tatzelbrumm/gf180_cm_ip__single2diff2single/README.md

# Single-ended / Differential / Single-ended Analog Pad Converter (GF180MCU)

> [!NOTE]
> **Status (2026-10-06):** skeleton. This repository is the GF180MCU (`gf180mcuD`, Chipalooza #3) port of the IHP sg13cmos5l design `sg13cmos5l_cm_ip__single2diff2single`. The build files (`Makefile`, the `xschemrc` files, `submission.yaml`, `.gitignore`, `scripts/`) now target GF180MCU, and every IHP design file has been removed. **No layout, schematic, testbench or netlist exists yet and no Makefile target has been run.** The GF180 harness is unpublished, so slot size, pin interface and precheck rules are assumptions carried over from the IHP version; anything marked *unverified* below is such an assumption. See [`CLAUDE.md`](CLAUDE.md), [`docs/IHP_TO_GF180_PORT_MAP.md`](docs/IHP_TO_GF180_PORT_MAP.md) and [`harness_stub/README.md`](harness_stub/README.md).

(c) 2026 Tim Edwards and Simon Dorrer (the build flow derives from their Chipalooza analog project template)

> [!IMPORTANT]
> This repository requires the [IIC-OSIC-TOOLS](https://github.com/iic-jku/IIC-OSIC-TOOLS) container with tag `2026.08` or later, and a tag that ships the `gf180mcuD` PDK (install it with Ciel otherwise). Not yet checked for the tag you use.

> [!TIP]
> If you want to use `nix-shell` instead of the container, have a look here: [heichips26-template](https://github.com/HeiChips/heichips26-template).

Single-ended analog pads are all a shared-die platform hands to each participant, while on-chip analog blocks should be fully differential for signal range and supply rejection. This design bridges the two: a single-ended analog **input pad** is buffered into a fully differential on-chip signal, and a differential-in **output driver** buffers it back out to a single-ended analog **output pad**.

The top level `gf180_cm_ip__single2diff2single` is drawn **by hand** (analog on top) and uses a **recursive macro structure**: it embeds the two sub-macros [`gf180mcu_IOPadSingle2Diff`](macros/gf180mcu_IOPadSingle2Diff/README.md) (input pad, CDM protection, single-ended-to-differential buffer) and [`gf180mcu_IOPadDiff2Single`](macros/gf180mcu_IOPadDiff2Single/README.md) (class-AB differential-to-single-ended driver, output pad). The pads come from Tim Edwards' `gf180mcu_ocd_io__asig_5p0`, which has HBM diodes only; the CDM protection next to the gates is part of this design.

The whole flow runs inside the [IIC-OSIC-TOOLS](https://github.com/iic-jku/IIC-OSIC-TOOLS) container: Xschem, ngspice, Magic, Netgen, KLayout and the `sak-*` helper scripts.

> [!IMPORTANT]
> `top-cell` in [`submission.yaml`](submission.yaml) has to match `TOP` in the [`Makefile`](Makefile), the file names below and the top cell inside the GDS. The intended name is `gf180_cm_ip__single2diff2single` (not final until confirmed, see `CLAUDE.md` section 1).

[`submission.yaml`](submission.yaml) describes the submission and is what the precheck reads. It carries these fields:

| Field | Meaning |
| --- | --- |
| `project-name` | free-text name of the project |
| `top-cell` | the macro's cell name, unique across all submissions |
| `team-members` | one list entry per person |
| `slot-size` | `tiny`, `small` or `large` (IHP sizes 200 x 200, 500 x 200 and 500 x 415 µm). *Unverified for GF180.* |
| `analog-pins` | how many analog pins the macro uses, `0`-`3`. *Unverified for GF180* (the IHP design used three: vin, vout, vcm). |
| `short-description` | one line |
| `long-description` | the project documentation, Markdown in a YAML block scalar |
| `gds-path`, `lef-path`, `header-path` | globs for the three deliverables, each must match **exactly one** file |

Because the submission macro is the **top level** of this repository rather than a folder under `macros/`, the three paths are relative to the repository root:

```yaml
gds-path: final/gds/*.gds
lef-path: final/lef/*.lef
header-path: final/vh/*.vh
```

They are produced by `make build-top`, so run it once before submitting.

To rename the project, change `TOP` in the [`Makefile`](Makefile) (every target derives its file names from it) and in the two macro Makefiles if a macro is renamed, and rename the files that carry the name:

- `layout/klayout/<TOP>.klay.gds` and `.klay.klib`, `layout/gds/<TOP>.gds`, **and the top cell inside the GDS files** (open in KLayout, rename the cell, save). The DRC, LVS and PEX targets pass the file name as the cell name, so the two must match.
- `schematic/xschem/<TOP>.sch` and `.sym` (`_pex.sym` is regenerated by `symbol-pex`)
- `testbenches/xschem/<TOP>_tb_tran.sch`
- `testbenches/xschem/plot_simulations/plot_<TOP>.py`

Then search and replace the remaining occurrences inside those files (Xschem schematics and the plot script are plain text): the DUT symbol instances, the `.include` of the PEX netlist in the testbench, and the raw file names in the plot script. Finally set `top-cell` in [`submission.yaml`](submission.yaml) to the same name.

## Directory Structure

<details>
<summary>Show Directory Structure</summary>

```text
📁 gf180_cm_ip__single2diff2single/            # <TOP> = the top-cell name, see CLAUDE.md §1
├─ .designinit  .gitignore  .gitattributes  LICENSE
├─ CLAUDE.md  README.md  Makefile  submission.yaml
├─ 📁 docs/                          # GF180_PROCESS_OPTIONS, OPERATING_LIMITS, IHP_TO_GF180_PORT_MAP
├─ 📁 dependencies/                  # links to gf180mcu_ocd_io etc.; nothing vendored yet
├─ 📁 harness_stub/                  # assumed slot interface until the GF180 harness is published
├─ 📁 floorplan/                     # GF180 slot templates: none exist yet (README only)
├─ 📁 final/                         # generated by `make build-top`, absent until the first run
│  ├─ 📁 gds/  📁 lef/  📁 lib/  📁 vh/       # <TOP>.gds, .lef, .lib, .vh
├─ 📁 layout/
│  ├─ 📁 klayout/                    # KLayout editing source: <TOP>.klay.gds + <TOP>.klay.klib
│  ├─ 📁 magic/                      # Magic editing source (*.mag), only for a cell authored in Magic
│  └─ 📁 gds/                        # exported static <TOP>.gds, what every build and sign-off target reads
├─ 📁 macros/
│  ├─ 📁 gf180mcu_IOPadSingle2Diff/  # analog input pad + CDM protection + S2D buffer
│  │  ├─ Makefile  README.md
│  │  ├─ 📁 layout/{klayout,magic,gds}/   # same three roles as at the top level
│  │  └─ 📁 schematic/xschem/  📁 testbenches/xschem/  📁 scripts/   # xschemrc files, check_pex_ports.py
│  ├─ 📁 gf180mcu_IOPadDiff2Single/  # D2S class-AB driver + analog output pad, same structure
│  ├─ 📁 ClassABDriver/  📁 ClassABBias/  📁 PadEnable/   # building blocks of the pads (2026-10-08)
│  └─ 📁 OgueyAebischerBias/         # resistor-free bias reference
├─ 📁 netlist/                       # generated, absent until the first run
│  ├─ 📁 layout/                     # *_klayout.cir (KLayout LVS), *_magic.ext.spc (Magic LVS)
│  ├─ 📁 pex/                        # *_magic_pex_*.spice
│  └─ 📁 schematic/                  # *_klayout.cdl, *_magic.spice
├─ 📁 render/img/                    # generated
├─ 📁 schematic/xschem/              # <TOP>.sch, .sym, _pex.sym, xschemrc
├─ 📁 scripts/                       # check_boundary.py, check_pex_ports.py, extract_pad.py, pcells/
├─ 📁 testbenches/xschem/            # <TOP>_tb_tran.sch, plot_simulations/, xschemrc
└─ 📁 verification/                  # generated
   ├─ 📁 drc/  <cell>.klayout.drc/  <cell>.magic.drc/
   └─ 📁 lvs/  <cell>.klayout.lvs/  <cell>.magic.lvs/
```

</details>

## Recursive Macro Structure

This project embeds two sub-macros in `macros/`, and each level has its own Makefile with the same targets:

- **Top level (`gf180_cm_ip__single2diff2single`)**: the hand-drawn submission macro. Its layout instantiates the two macros below. Its Makefile verifies and builds the **top cell only** (`CELL` defaults to `gf180_cm_ip__single2diff2single`).
- **[`macros/gf180mcu_IOPadSingle2Diff/`](macros/gf180mcu_IOPadSingle2Diff/README.md)** (`TOP = gf180mcu_IOPadSingle2Diff`): analog input pad, CDM protection, single-ended-to-differential buffer.
- **[`macros/gf180mcu_IOPadDiff2Single/`](macros/gf180mcu_IOPadDiff2Single/README.md)** (`TOP = gf180mcu_IOPadDiff2Single`): class-AB differential-to-single-ended driver and analog output pad.
- **[`macros/OgueyAebischerBias/`](macros/OgueyAebischerBias/README.md)** (`TOP = OgueyAebischerRef_<VARIANT>`, `VARIANT` = `03v3` or `06v0`): resistor-free bias current reference with start-up, ported from IHP in two device-family variants. Has `sim-cace` / `sim-cace-all` targets. Not yet part of `build-macros`.
- **[`macros/ClassABDriver/`](macros/ClassABDriver/README.md)**: the class-AB driver core (matched-pair DDA, folded cascode, class-AB output, Miller compensation) and its CACE fixture `ClassABDriverBiased`; ported from the IHP design notes, re-sized for GF180 (2026-10-08).
- **[`macros/ClassABBias/`](macros/ClassABBias/README.md)**: the driver's bias trees `ClassABBiasIn` / `ClassABBiasOut` (reference current into / out of `iref`) and the ideal fixture `ClassABBiasIdeal`, each with its own CACE suite.
- **[`macros/PadEnable/`](macros/PadEnable/README.md)**: enable cells of the analog pads (`EnableInv`, `DriverEnable`, `BiasRefEnable`, `InputEnable`).
  Their Makefiles (and the changes to the existing ones: `sim-cace`, `sim-cace-all`, `make sim-cace-macros` at the top) come as a package, because the bridge cannot write Makefiles: `_sudelbuecher/sudelbuecher/deliveries/2026-10-08_opus_makefiles.zip`, installed with its `install.sh`.

The macro Makefiles were derived from the template's analog sub-macro Makefile; its CACE characterization targets were dropped, and the PDK, layout and name strings were retargeted. They have not been run for GF180. Every level follows the same principle, and the simulations always run last, so they use the artifacts the same invocation has just produced:

| Makefile | `all` flow |
| --- | --- |
| each macro | verify (DRC, LVS, PEX) → build (LEF, LIB, Verilog stub, GDS, render) → simulate |
| top level | build macros → verify (DRC, LVS, PEX) → build (boundary check, LEF, LIB, Verilog stub, GDS, render) → simulate |

**Build order matters**: if you modify a sub-macro, run its own flow first (`make -C macros/gf180mcu_IOPadSingle2Diff all`, or equivalently `make build-single2diff` / `make build-diff2single` from here), then rebuild the top level. The top-level `make all` does this automatically by running `build-macros` before verifying and building the top cell. A macro's exported GDS `layout/gds/<macro>.gds` is what the top-level `.klib` binds to, see the next sections.

## Floorplan Templates

None for GF180 yet. The IHP slot templates were removed because their geometry, pin positions and layers do not apply. Slot geometry, wrapper interface and precheck rules arrive with `gf180mcu_ocd_chipalooza`, which is still empty; until then [`harness_stub/README.md`](harness_stub/README.md) holds the assumed interface and [`floorplan/README.md`](floorplan/README.md) the status.

## Layout Sources and the Exported Tapeout GDS

`layout/` is split by role, the same "source vs. derived artifact" idiom as `netlist/{schematic,layout,pex}` and `verification/{drc,lvs}`. The file's location tells you whether it is safe to edit or gets overwritten by a re-export. Every macro under `macros/` uses the same three subdirectories.

| Directory | Holds | Edited by hand? |
| --- | --- | --- |
| `layout/klayout/` | KLayout editing source `<TOP>.klay.gds` + `<TOP>.klay.klib` (live PCells, library references), plus KLayout's own generated folders (`backups/`, `drc_run_*`, `lvs_run_*`) | yes |
| `layout/magic/` | Magic editing source `*.mag`, only for a cell that is authored in Magic | yes, if used |
| `layout/gds/` | exported static `<TOP>.gds`: no PCells, no library indirection | never, regenerate |

Rules:

1. **One authoring tool per cell.** Two hand-edited sources of the same cell have no merge story: edit one and the other silently goes stale, and only a DRC/LVS mismatch reveals it. The directory of the tool that is not used stays empty (`.gitkeep`) or carries a short `NOTE.md` saying so, for example "this cell is authored in KLayout, see `layout/klayout/`".
2. **The export always goes to `layout/gds/<cell>.gds`**, whichever tool authored the cell. `gds` is the tool-agnostic exported view, the counterpart of `final/gds/` one level up; it is not "KLayout's output folder", which is why it is not the partner of `magic`. Every DRC, LVS, PEX and build target reads this file. If both tools ever produce a GDS of the same cell, they get tool suffixes, `<cell>_klayout.gds` and `<cell>_magic.gds`, exactly like `netlist/layout/*_klayout.cir` next to `*_magic.ext.spc`, and never overwrite each other.
3. **A parent binds a child macro to the child's exported GDS, never to its editing source.** In `layout/klayout/<TOP>.klay.klib` the `lib_path` of a macro is `../../macros/<macro>/layout/gds/<macro>.gds` (relative to the `.klib`). The hierarchy therefore only consumes a finished snapshot of the level below and never reaches into its live editing state. Rename a macro and `lib_name` and `lib_path` must follow.
4. **Launch KLayout from the file's own directory**, `cd layout/klayout && klayout -e <TOP>.klay.gds`, because the relative `lib_path` depends on it. `make open` does this.

> [!IMPORTANT]
> Re-export to `layout/gds/<TOP>.gds` with `File > Export Layout For Tapeout` after every layout change and never hand-edit the exported file. Keeping the two in step by editing both is how they drift apart, and the drift is invisible because the sign-off targets only look at the exported file.

The export re-evaluates the PCells against the **installed** PDK, so device geometry can change even though nobody touched the editing source. A layout carried over from another PDK, another PDK revision or a different template therefore has to be re-exported under the target PDK and re-checked, not copied. This applies to everything inherited from the IHP version of this design. Re-run DRC, LVS and PEX after every export.

The Makefiles follow this convention strictly: every DRC, LVS, PEX and build target reads `layout/gds/<cell>.gds` and nothing else (`LAY_GDS_DIR` in the Makefile). The IHP sibling project's Makefile falls back to `layout/klayout/<cell>.klay.gds` when no exported GDS exists; this project deliberately does not, so a forgotten export fails loudly instead of checking a stale or unresolved source. The three-directory convention and its history are discussed in the IHP sibling project's notes: [`2026-09-27_sonnet_single2diff2single_toplevel_structure_and_chipalooza_magic_authoring.md`](../sg13cmos5l_cm_ip__single2diff2single_sudelbuecher/sudelbuecher/chatlog/2026-09-27_sonnet_single2diff2single_toplevel_structure_and_chipalooza_magic_authoring.md), Turns 14, 19 and 21 to 23.

## Xschem Configuration

Xschem reads exactly one `xschemrc` at start-up, and that file decides which symbol libraries are visible and where netlists and simulation output are written. This project ships one per folder that holds schematics:

| `xschemrc` | Belongs to |
| --- | --- |
| [`schematic/xschem/xschemrc`](schematic/xschem/xschemrc) | top-level schematics |
| [`testbenches/xschem/xschemrc`](testbenches/xschem/xschemrc) | top-level testbenches |
| [`macros/gf180mcu_IOPadSingle2Diff/schematic/xschem/xschemrc`](macros/gf180mcu_IOPadSingle2Diff/schematic/xschem/xschemrc) | input pad macro schematics |
| [`macros/gf180mcu_IOPadSingle2Diff/testbenches/xschem/xschemrc`](macros/gf180mcu_IOPadSingle2Diff/testbenches/xschem/xschemrc) | input pad macro testbenches |
| [`macros/gf180mcu_IOPadDiff2Single/schematic/xschem/xschemrc`](macros/gf180mcu_IOPadDiff2Single/schematic/xschem/xschemrc) | output driver macro schematics |
| [`macros/gf180mcu_IOPadDiff2Single/testbenches/xschem/xschemrc`](macros/gf180mcu_IOPadDiff2Single/testbenches/xschem/xschemrc) | output driver macro testbenches |
| [`macros/OgueyAebischerBias/schematic/xschem/xschemrc`](macros/OgueyAebischerBias/schematic/xschem/xschemrc) | bias macro schematics |
| [`macros/OgueyAebischerBias/testbenches/xschem/xschemrc`](macros/OgueyAebischerBias/testbenches/xschem/xschemrc) | bias macro testbenches |
| `macros/{ClassABDriver,ClassABBias,PadEnable}/{schematic,testbenches}/xschem/xschemrc` | building blocks of the pads; each also appends the sibling macros it instantiates |

### What Every File Does

All of them run the same four steps, in this order:

1. **Pick the PDK.** `PDK_ROOT` is probed in the usual install locations if the environment does not set it, and `PDK` falls back to `gf180mcuD`. The container already exports `PDK_ROOT`, and [`.designinit`](.designinit) exports `PDK`, so this step is only a safety net for an Xschem started outside that environment.
2. **Source the PDK `xschemrc`.** `$PDK_ROOT/$PDK/libs.tech/xschem/xschemrc` brings in the GF180 device symbols, the ngspice model paths and the PDK menu. It is guarded by `[info exists PDK]` so it is read once even when several project files are chained.
3. **Add the project library paths.** `append_xschem_library_path_unique` appends a folder to `XSCHEM_LIBRARY_PATH` only if it is not already there, so the same folder never appears twice no matter how the files are chained.
4. **Pin the netlist directory.** `pin_netlist_dir` decides where `xschem netlist` and the simulators write.

Both helper procedures are defined behind an `[info commands ...]` guard, so sourcing one file from another is harmless and the order does not matter.

### How the Files Are Chained

The top level pulls in everything below it:

```text
testbenches/xschem/xschemrc
└─ source schematic/xschem/xschemrc
   ├─ source macros/gf180mcu_IOPadSingle2Diff/schematic/xschem/xschemrc
   ├─ source macros/gf180mcu_IOPadDiff2Single/schematic/xschem/xschemrc
   ├─ source macros/OgueyAebischerBias/schematic/xschem/xschemrc
   ├─ source macros/ClassABBias/schematic/xschem/xschemrc
   ├─ source macros/ClassABDriver/schematic/xschem/xschemrc
   └─ source macros/PadEnable/schematic/xschem/xschemrc
```

Each schematic folder puts itself and its sibling testbenches folder on the library path, and each testbenches folder does the reverse. The top level therefore sees all the schematic and testbench folders, which is what lets the top-level schematic instantiate the macro symbols, and what lets you open a macro testbench from a top-level session. The macro files do not source each other or the top level, so a macro can be opened and simulated on its own. A macro that instantiates cells of another macro (the pads, `ClassABDriver`) appends that macro's `schematic/xschem` folder with a relative path instead (`../../../<Macro>/schematic/xschem`).

Add a further sub-macro to the top level by sourcing its `schematic/xschem/xschemrc` from [`schematic/xschem/xschemrc`](schematic/xschem/xschemrc), next to the existing `source` lines.

### Where Netlists and Simulation Output Go

`pin_netlist_dir` maps the folder of the schematic being netlisted to a `simulations/` folder:

| Schematic lives in | `netlist_dir` |
| --- | --- |
| `<x>/testbenches/xschem` | `<x>/testbenches/xschem/simulations` |
| `<x>/schematic/xschem` | `<x>/testbenches/xschem/simulations` |
| `.../cace/templates` | `.../cace/templates/simulations` (kept from the template, no CACE folder exists here) |
| anywhere else (a PDK example) | left at the value the `xschemrc` pinned |

It runs twice: once while the `xschemrc` is read, using that file's own folder, and again through Xschem's `load_file_postprocess` hook for every schematic that is opened afterwards. The second call is the important one. Because the top level puts the macro folders on the library path, a macro testbench can be opened from a top-level session, and without the hook its netlist would land in `testbenches/xschem/simulations/`. Its relative includes such as `.include ../../../netlist/pex/gf180mcu_IOPadSingle2Diff_magic_pex_3.spice` are resolved by ngspice relative to the netlist file, so they would then point at the wrong tree and the simulation would abort. With the hook, the netlist always lands next to its own schematic and the includes resolve.

A `set netlist_dir` passed on the Xschem command line still wins, because `--command` runs after the file is loaded. The LVS netlist targets rely on this to write into `netlist/schematic/` instead.

All `simulations/` folders are generated and git-ignored.

### Which File Is Used

- The Makefile targets always name one explicitly with `--rcfile`, so a target behaves the same from any working directory.
- Starting Xschem from within one of the folders above picks up that folder's file, which is the normal interactive case. `make open` does the same, because it starts Xschem in the file's own directory.
- Started from anywhere else, Xschem falls back to `~/.xschem/xschemrc` and sees neither the project symbols nor the pinned `netlist_dir`. Pass the file explicitly then, for example `xschem --rcfile schematic/xschem/xschemrc <file>`.

## Verification Scripts (`sak-*`)

The DRC, LVS, PEX, render and file-browser targets call the `sak-*` Swiss-Army-Knife scripts of the [IIC-OSIC-TOOLS](https://github.com/iic-jku/IIC-OSIC-TOOLS). They are pre-installed in the container and are on `PATH`, so the Makefiles call them by name and no copy is kept in this repository:

- `sak-drc.sh` — DRC with Magic or KLayout
- `sak-lvs.sh` — LVS with Magic + Netgen or KLayout
- `sak-pex.sh` — parasitic extraction with Magic
- `sak-pin-reorder.py` — reorders extracted `.subckt` pins to match an Xschem symbol
- `sak-render.py` — renders a layout GDS to PNG
- `sak-open.py` — the file browser behind `make open`

They read `PDK_ROOT`, `PDK`, `PDKPATH` and `STD_CELL_LIBRARY` from the environment. The container exports `PDK_ROOT`, and [`.designinit`](.designinit) exports the other three. IIC-OSIC-TOOLS sources `$DESIGNS/.designinit` at start-up, so the file is picked up automatically when this repository is the mounted design directory. If the repository sits in a subfolder of `$DESIGNS`, or you are in a shell that was not started that way, source it by hand before running any target:

```sh
source .designinit
```

Only two Python helpers are kept in [`scripts/`](scripts/) (each macro carries its own copy of `check_pex_ports.py`), because they are specific to this project:

- [`scripts/check_boundary.py`](scripts/check_boundary.py) — the PR boundary check, see below
- [`scripts/check_pex_ports.py`](scripts/check_pex_ports.py) — checks that every port of a PEX netlist is really connected

The `sak-render.py -t` tech name is a Makefile variable, `RENDER_TECH` (default `gf180mcuD`), and `gf180mcuD` is a PDK name that `sak-pdk` lists in the container, the same kind of name the IHP version passed. It has not yet been run through `sak-render.py` itself. KPEX has no verified GF180 support, so use the Magic PEX targets.

## Makefile Targets

The top-level Makefile has the same structure as each macro's (same variables, same targets) with `TOP = gf180_cm_ip__single2diff2single`; the macro Makefiles use their own macro name as `TOP`. The parameters are `CELL`, `EXT_MODE`, `THRESHOLD`, `MINRES`, `MINDELAY`, `DRC_LEVEL`, `EV_PRECISION`, `TB`, `SCRIPT`, `OPEN_ARGS` and `RENDER_TECH`, documented in the Makefile header and by `make help`. In short:

```sh
make                                     # help: all targets and variables
make open                                # file browser for this folder (needs the VNC/X11 desktop)
make klayout-verify-all                  # KLayout DRC + LVS of the top cell
make magic-verify-all                    # Magic DRC + LVS + PEX of the top cell
make check-boundary                      # PR boundary box check of the top cell layout
make build-top                           # boundary check, LEF, LIB, Verilog stub, final GDS, render
make build-single2diff                   # full flow of the gf180mcu_IOPadSingle2Diff macro (make -C macros/... all)
make build-diff2single                   # full flow of the gf180mcu_IOPadDiff2Single macro
make build-macros                        # verify, build and simulate both macros
make sim-all                             # run all top-level testbenches
make sim-xschem                          # top-level transient (default: <CELL>_tb_tran, needs magic-pex first)
make sim-xschem TB=<testbenchname>       # run another testbench
make sim-view-xschem                     # plot the results (default: plot_<CELL>)
make sim-view-xschem SCRIPT=<scriptname> # run another plotting script
make all                                 # build-macros + verify + build + simulate
make clean                               # delete the top level's generated files (final, netlist, render, reports, simulations)
make clean-single2diff                   # run make clean in the gf180mcu_IOPadSingle2Diff macro
make clean-diff2single                   # run make clean in the gf180mcu_IOPadDiff2Single macro
make clean-macros                        # run make clean in both macros
make clean-all                           # clean-macros + clean
```

The per-step targets behind these all take `CELL=<cellname>`: `klayout-drc`, `klayout-lvs-netlist`, `klayout-lvs`, `klayout-pex`, `klayout-verify`, `magic-drc`, `magic-lvs-netlist`, `magic-lvs`, `magic-pex`, `magic-verify`, `symbol-pex`, and the build steps `lef`, `lib`, `verilog`, `copy-gds`, `render-gds`. The `verilog` target recognizes the supply pins `VDD`, `VSS`, `VPWR`, `VDPWR`, `VAPWR`, `VGND`, `VNB`, `VPB` and the direction prefixes `di_`/`do_`; adjust both once the harness's supply and pin naming is known.

### Open the Design Files

Opens a file browser for this folder with `sak-open.py`, one button per design file, grouped by directory. Clicking a button launches the matching tool (Xschem, KLayout in edit mode, Magic, GTKWave, gaw, gvim) in the file's own directory:

```sh
make open
make open OPEN_ARGS=--all              # include the build outputs
make open OPEN_ARGS="--prune backups"  # skip one more directory name
```

> [!NOTE]
> This target needs a display. Run it inside the container's VNC/noVNC desktop or over X11 forwarding. In a shell-only container it stops with `cannot open a window`.

### PR Boundary Check

Checks that the top cell of `layout/gds/<TOP>.gds` draws the PR boundary box on layer 0 (`PR_bndry`, 0/0). `build-top` runs it first:

```sh
make check-boundary
```

The layer number is *unverified* against the harness: it is read from the PDK sources (`PR_bndry 0/0` in `gf180mcu.lyp`, `calma BOUND 0 0` in `gf180mcuD.tech`; the IHP value was 189) and has not been checked against a real GF180 GDS or the precheck. Override it with `scripts/check_boundary.py --layer <n>`. The IHP chip flow derived the bounding box of every macro from this layer, and a layout without the box failed the whole chip build with `Failed to extract PR boundary from GDSII view of macro '<TOP>'`; whether the GF180 flow works the same way is not known until the harness is published. The check runs [`scripts/check_boundary.py`](scripts/check_boundary.py), which also warns when the drawn geometry extends beyond the boundary box.

The sub-macros have no such target: the box is only needed by the cell the chip flow places, which is the top level.

### Differences to the Sub-Macros

- `sim-all` runs only the top-level testbenches (`<TOP>_tb_tran`). The testbench simulates the schematic by default and includes the extracted PEX netlist by swapping the DUT to the `_pex` symbol for a post-layout run. That symbol, `schematic/xschem/<CELL>_pex.sym`, is built by the `symbol-pex` target, which `klayout-pex` and `magic-pex` run automatically before every extraction. The macros' own testbenches live in `macros/<macro>/testbenches/xschem/`.
- `klayout-verify-all`/`magic-verify-all` verify the top cell only; the macros are covered by `build-macros` (or run the macro's own `make`).
- `build-top` additionally runs `check-boundary` first, see above.
- `make all` first runs `build-macros`, so the sub-macros are verified, built and simulated before the top cell.
- `clean` deletes only the top level's generated files (`final/`, `netlist/`, `render/img/`, the DRC/LVS reports, and the simulation outputs). `clean-macros` runs `make clean` in every sub-macro, and `clean-all` combines both, mirroring `build-macros`/`all`.

> [!NOTE]
> The top-level testbench is expected to `.include` the extracted PEX netlist `netlist/pex/<TOP>_magic_pex_3.spice`, and `make verilog` reads its pin list from a PEX netlist as well. Directly after `make clean`, run `make magic-pex` (or the full `make all`) once before `make sim-xschem`, `make sim-all` or `make build-top`, otherwise the include fails.

> [!WARNING]
> If you commit the generated outputs, `make clean` leaves a large deletion set in `git status`. Run `git restore .` to get them back if you did not mean to remove them.

## License

Copyright 2026 Tim Edwards and Simon Dorrer.

Licensed under the **Solderpad Hardware License v2.1** (`Apache-2.0 WITH SHL-2.1`), see [`LICENSE`](LICENSE). Source files carry an `SPDX-FileCopyrightText` header; layout data, netlists, renders and generated reports cannot carry one and are covered by this notice.
