tatzelbrumm/gf180_cm_ip__single2diff2single/dependencies/README.md

# dependencies

Nothing is vendored yet. Links only:

- [gf180mcu_ocd_io](https://github.com/RTimothyEdwards/gf180mcu_ocd_io): analog and digital I/O cells (dual-voltage, 3.3 V core / 5 V pad); analog pad is cell `asig_5p0`
- [gf180mcu_ocd_chipalooza](https://github.com/RTimothyEdwards/gf180mcu_ocd_chipalooza): the harness (empty as of 2026-09-30)
- [gf180mcu_ocd_ip__analog_switches](https://github.com/RTimothyEdwards/gf180mcu_ocd_ip__analog_switches): analog and power switches
- [google/gf180mcu-pdk](https://github.com/google/gf180mcu-pdk): original PDK sources; `gf180mcuD` comes via open_pdks / Ciel
