tatzelbrumm/gf180_cm_ip__single2diff2single/macros/ClassABBias/README.md

<!--
SPDX-FileCopyrightText: 2026 Christoph Maier
SPDX-License-Identifier: Apache-2.0
-->
# ClassABBias (GF180MCU)

Bias of the class-AB pad driver (`../ClassABDriver`): six bias lines, generated by diode-connected devices on the
rail of the devices they bias, so that bias crosses from block to block as currents only.

| line | current | diode | biases (in ClassABDriver) |
|---|---|---|---|
| vbp | 5 µA out of | BP 20u/6u nf=2 | DDA unit tails Ta, Tb |
| vbn | 5 µA into | BN 6u/6u | fold sinks SX, SY |
| vbpc | 2 µA out of | BPC 1u/4u | mirror cascodes PCL, PCR |
| vbnc | 2 µA into | BNC 1u/8u | fold cascodes CX, CY |
| vabp | 5 µA out of | RP2 6.66u/0.6u on RP1 12u/0.6u nf=2 | class-AB control ABP, FPL |
| vabn | 5 µA into | RN2 4.4u/1u on RN1 8u/1u nf=2 | class-AB control ABN, FNL |

RP1 and RN1 are the replicas of the output devices OP and ON and sit on the output-stage rails vddo / vsso, like
OP and ON: any voltage between vdd and vddo adds to the translinear loop and moves the quiescent current. In layout,
RP1's source is taken from OP's source rail and RN1's from ON's (Kelvin). RP2's n-well stays on vdd, like ABP's.

**Status: proof of concept (2026-10-08).** Schematics, symbols and CACE suites; no layout. Port of the IHP
sg13cmos5l design notes (`sg13cmos5l_..._sudelbuecher/sudelbuecher/design_considerations/class_ab_pad_driver/improvements/`:
`bias.md`, `sim/d2s_bias_ref.spice`, `xschem/d2s_bias_*.sch`), 03v3 devices at 3.3 V.

## Cells

| cell | IHP sheet | ports | content |
|---|---|---|---|
| `ClassABBiasIn` | `d2s_bias_in` | vdd vss vddo vsso iref vbp vbn vbpc vbnc vabp vabn | variant 1: 5 µA **into** iref (external PMOS source) → NMOS input diode NI 6u/6u; NI's gate line drives the sinks out of the PMOS diodes, BP's gate line the sources into the NMOS diodes |
| `ClassABBiasOut` | `d2s_bias_out` | same | variant 2: 5 µA **out of** iref (external NMOS sink) → PMOS input diode PI 20u/6u |
| `ClassABBiasIdeal` | `d2s_bias_lp` | vdd vss vddo vsso + six lines | test fixture: ideal currents into the same six diodes (used by `ClassABDriverBiased`) |

| `ClassABBiasBG` | `bg_core` (re-designed) | vdd vss iout en en_b | **self-contained bandgap reference**, 5 µA **out of** iout, for the `ClassABBiasIn` tree's iref; with start-up and the disable switches SPG / SKS inline (2026-10-09, see below) |
| `ClassABBiasBGdn` | same | same | the same core with the NMOS pair NA / NB in isolated p-wells (deep n-well), bulk tied to source |
| `ClassABBiasBGTree`, `…BGdnTree` | — | as `ClassABBiasIn` plus en en_b, without iref | CACE fixtures: reference feeding the tree (iout → iref directly) |

Each tree sheet is flat at transistor level, as on IHP: reference [R], mirror tree and the six diodes [8]. The
Oguey–Aebischer variant (`d2s_bias_oa`) is not ported (deferred 2026-10-08; it needs a GF180 re-design: the IHP MS1
is 0.5/100 µm, the bin ends at L = 50 µm).

The pad (`../gf180mcu_IOPadDiff2Single`) uses `ClassABBiasIn` behind `PadEnable/BiasRefEnable`.

## Sizing (re-derived for GF180, 2026-10-08)

Started from the IHP geometry; changed where GF180 simulation required it (details: notes worktree,
`logs/main/2026-10-08_opus_classab_port_log.md`):

- vbp diode BP and its copies 5u/6u → 20u/6u nf=2, together with the DDA unit tails: at ss/3.0 V/−40 °C the
  5u/6u tails had V_DS 0.35 V below V_DSsat 0.43 V.
- RP1 13.32u → 12u/0.6u, RN1 8.8u → 8u/1u: quiescent current of the driver 212 µA, as on IHP.
- NBPC 2.4u → 2.5u/6u: narrow-width error of the 2 µA line −3.6 % → +0.7 %.

The source of the port is `../ClassABDriver/scripts/gf180_sizing.spice`; `port_classab_from_ihp.py` and
`check_classab_port.py` there drew the sheets from the IHP drawings and compare xschem's netlists with it
(MISMATCHES 0 on 2026-10-08).

## CACE (`verification/cace/`, results in `verification/cace/results/<cell>/`)

```
cd verification/cace
cace ClassABBiasIn.yaml -s schematic --nofail -j 4 --parallel-parameters 1
```

Three parameters per cell, about 1 min each: bias-current errors over 5 MOS corners × −40/27/125 °C × 3.0/3.3/3.6 V,
DC line sensitivity (vdd = vddo 3.0 → 3.6 V), local mismatch (100 iterations). Limits are placeholders.

| | ClassABBiasIn | ClassABBiasOut |
|---|---|---|
| current errors over PVT | −1.7 … +2.9 % | −1.5 … +3.4 % |
| line sensitivity vbn / vabp | 0.8–1.3 / 0.6–1.1 %/V | 0.19–0.23 / 0.8–1.3 %/V |
| mismatch, 100 runs, extremes | −1.7 … +3.6 % | −1.7 … +3.8 % |
| supply current (without iref) | 24 µA | 29 µA |

Generated by `scripts/gen_cace.py`; edit the yaml and templates from now on. Currents are read as
`@m.x1.<device>.m0[id]` of the diodes inside the DUT; errors are echoed as fractions because CACE shows a unit of
`%` as 100 × the value.

## ClassABBiasBG — the bandgap reference (GF180 re-design, 2026-10-09)

Current-mode (Banba) bandgap without op-amp, as the IHP `bg_core` (`bias.md`, variant 4): the PMOS mirror makes the
two branch currents equal and the NMOS pair NA / NB forces ea = eb, so each branch carries V_BE1 / R1 + U_T ln 8 / R0
with Q2 = 8 × Q1 (`pnp_05p00x05p00`, 25 µm² each, ratio by `m`); PO / POC = 2 × → 5 µA. Not a transliteration;
what changed for GF180 and why (numbers: notes worktree, `logs/main/2026-10-08_fable_reference_redesign_log.md`,
harness `kickoffs/2026-10-08_reference_redesign/tools/`):

- **Wide-swing cascode instead of the stacked-diode cascode.** With pfet_03v3's |V_T| the IHP structure
  (vpc = vdd − 2 V_SG ≈ 1.0 V at ss / 3.0 V / −40 °C) leaves NB no V_DS. Now the input branch's diode connection
  closes around the cascode PBC (vpg = its drain) and the cascode gate line is vpc = vpg − I·RC with RC = 150 kΩ
  (`ppolyf_u_3k` 1u/50u) between the two gate lines; NB's drain sits on vpc. Every mirror device has V_SD = I·RC
  (0.31–0.37 V), every cascode V_SG − I·RC. Costs one resistor.
- **Resistors `ppolyf_u_3k`, 1 µm wide** (R1B 107.4 µm ≈ 325 kΩ, R1A 118.1 µm — 10 % longer, the IHP trick against
  the resistor-only false state — R0 32.8 µm ≈ 100 kΩ): 308 µm of strip in all, ≈ 450 µm² with spacing. Its TC
  (−0.154 %/K) makes the balance 68 % CTAT / 32 % PTAT; its tc2 (3.7e-6/K²) is what limits the drift (the band over
  −40…125 °C is 3.0 % wide, with `ppolyf_u_1k` it would be 2.1 % at 2.8 × the resistor area — a one-line swap in
  `scripts/bg_reference.spice` + `gen_bg.py` if the drift ever matters more than the area). The band is centred on
  5 µA: 27 °C sits at +1.5 %, the ends at −1.2 / −1.4 %.
- **NMOS pair 20/12** (was 20/4): NB's V_DS moves 1:1 with vdd, and its g_ds / g_m is an input offset of the pair;
  the long channel halves the line sensitivity.
- **PMOS mirror 48/4 nf=4, cascodes 48/2 nf=4**, PO / POC 96/4, 96/2 nf=8 (one instance each; the mismatch model
  ignores `m` and the bin ends at W = 100 µm). The mirror devices set the mismatch (48/2: σ 1.8 %, 48/4: 1.0 %).
- **Start-up** [S] as on IHP but pulling the mirror gate line vpg: MS1 0.22/50 (weak pull-up on ks, gate on en_b),
  MS2 senses g, MS3 pulls vpg. **Disable** [E]: SPG (vpg → vdd) and SKS (ks → vss) while en = 0, 1u/0.5u, drawn inline;
  `PadEnable/RefCoreEnable` holds the same two devices as a cell of its own (unused for now).
- Gate area ≈ 1660 µm² MOS (IHP: 541), 25 × 9 = 225 µm² of PNP emitters (IHP: 36), resistors ≈ 450 µm².

Results (plain-ngspice harness and CACE, schematic, cloud toolchain: xschem 3.4.8RC, ngspice-47, gf180mcuD 1689ac3,
CACE 2.13; `verification/cace/results/ClassABBiasBG/`):

| | target (2026-10-08) | `ClassABBiasBG` | `ClassABBiasBGdn` |
|---|---|---|---|
| iout, 27 °C / 3.3 V / tt | 5 µA | 5.077 µA (+1.5 %) | 5.086 µA |
| MOS corners × 3.0/3.3/3.6 V × −40/27/125 °C | ±3 % | −1.6 … +1.7 % | −1.5 … +1.9 % |
| process spread, resistor / PNP corners (report) | — | res_ss / res_ff −19 / +36 % (R_sh ±25 %, no trim); bjt_ss / ff +2.6 / +0.7 % | same |
| DC line sensitivity, 3.0 → 3.6 V, MOS × res corners × temp | ≤ 1 %/V | 0.0 … 0.42 %/V | 0.11 … 0.58 %/V |
| AC from vdd (harness, tt), 1 k / 100 k / 1 MHz | — | 0.42 / 3.5 / 14 %/V | 0.6 / 1.3 / 8 %/V (depends on the well capacitance) |
| start-up, 1 µs ramp, 5 MOS corners × 3.0/3.6 V × −40/27/125 °C | required | settled within ±10 % ≤ 1.3 µs after the ramp, at the DC point | same |
| start-up, 1 ms ramp | required | settled 125–580 µs before the ramp ends | same |
| mismatch, 100 runs (MOS + PNP; the PDK has no resistor mismatch) | σ ≤ 2 % | σ 1.06 %, extremes −1.2 / +4.0 % | σ 1.15 %, −1.2 / +4.4 % |
| disabled (en = 0), 3.0–3.6 V, −40…125 °C | — | I_dd 0.02–0.24 nA, iout ≤ 0.07 nA | I_dd ≤ 1.3 nA (well junctions) |
| supply current, enabled | — | 10.0–10.7 µA (4 branches of 2.5 µA + MS1) | same |
| with the tree (`…BGTree`): six lines over MOS corners × V × T | ±5 % (placeholder) | −3.0 … +3.7 % (`ClassABBiasIn` with an ideal 5 µA: −1.7 … +2.9 %); I_dd 34–36 µA | −3.0 … +3.9 % |

Substrate noise (harness, AC on the NMOS bulks / PNP collectors only, vss clean): `ClassABBiasBG` 0.16 / 13.5 / 51 %/V at
10 Hz / 100 kHz / 1 MHz, `ClassABBiasBGdn` ≈ 0 at every frequency — that is what the deep n-well buys; it costs the
body effect (g_mb no longer helps the pair, DC line sensitivity 0.42 → 0.62 %/V), ≈ +500–700 µm² (DNW enclosure
2.5 µm, N-well ring, PCOMP guard ring, 3.1 µm keep-out to other N-wells; DRC-rule estimate, no layout) and the well
junctions, modelled as `diode_pw2dw` / `diode_dw2ps` with guessed areas. LVS extracts an NMOS in a DNW as plain
`nfet_03v3` with the p-well as bulk net, and the well diodes only under a `well_diode_mk` marker.

Informative, 06v0 devices substituted at the same sizes, 4.5–5.5 V (harness): works, +2.8 % at 5.0 V, drift as 3.3 V,
line sensitivity 1.2 %/V (NB's V_DS swings 2 V; a 5 V version would want a longer NB or a cascode), MS1 ≥ 0.3 µm wide.

Driver `ClassABDriver` with the reference (harness, 1 kΩ ∥ 100 pF, resistors typical): I_Q 200–220 µA over
ss/3.0 V/−40 °C … ff/3.6 V/125 °C (ideal fixture 205–218), T0 61–93 dB, PM 66–78°, offset ≤ 0.8 mV; the resistor
corners move I_Q to 172 / 286 µA (IHP rhigh: 171 / 268).

Files: `scripts/gen_bg.py` (sheets, symbols, fixtures), `scripts/bg_reference.spice` (sizes; round trip with
`../ClassABDriver/scripts/check_classab_port.py`, now also for PNPs, 1k resistors and diodes: MISMATCHES 0),
`scripts/gen_cace_bg.py` (datasheets and templates), `scripts/mm_sigma.py` (σ from a run's `.data` files).
The core sheets were generated in the label style of `PadEnable` and then re-wired by hand (Christoph, 2026-10-09:
real wires, gate trunks vpg / vpc / g / ks, the switches inline); `gen_bg.py` must not be re-run over them.

## Open points

- Enable: the switches live in `../PadEnable` (BiasRefEnable cuts iref and pulls NI's gate line low).
  `ClassABBiasOut` would need the mirror image of BiasRefEnable (pull PI's gate line to vdd); not drawn yet.
- Which reference feeds iref, and how many pads share it, is not decided; the bias tree is meant to sit in each pad.
  `ClassABBiasBG` is drawn to sit in front of `BiasRefEnable` (iout → iin); the pad does not instantiate it yet.
- `ClassABBiasBG`: the resistor spread (±25 % of R_sh → −19 / +36 % of the current, I_Q 172 / 286 µA) is the
  dominant error and would need a trim or a tolerant driver; the ±3 % drift target has 1.3 % margin with the 3k
  resistor (2 % with 1k); the deep-n-well choice is open (`ClassABBiasBGdn`).
- Oguey–Aebischer variant: not ported.
- No layout. RP1 / RN1 need the Kelvin connection to OP's / ON's source rails.
