tatzelbrumm/gf180_cm_ip__single2diff2single/macros/ClassABBias/verification/cace/results/ClassABBiasBG/dc_params.csv

run | vdd | temp | corner_mos | e_iout | Idd
run_00 | 3.0 | -40 | typical | -1.307e-02 | 1.024e-05
run_01 | 3.3 | -40 | typical | -1.221e-02 | 1.035e-05
run_02 | 3.6 | -40 | typical | -1.136e-02 | 1.048e-05
run_03 | 3.0 | 27 | typical | 1.373e-02 | 1.043e-05
run_04 | 3.3 | 27 | typical | 1.473e-02 | 1.053e-05
run_05 | 3.6 | 27 | typical | 1.573e-02 | 1.063e-05
run_06 | 3.0 | 125 | typical | -1.504e-02 | 1.009e-05
run_07 | 3.3 | 125 | typical | -1.385e-02 | 1.016e-05
run_08 | 3.6 | 125 | typical | -1.261e-02 | 1.025e-05
run_09 | 3.0 | -40 | ss | -1.378e-02 | 1.016e-05
run_10 | 3.3 | -40 | ss | -1.292e-02 | 1.025e-05
run_11 | 3.6 | -40 | ss | -1.208e-02 | 1.036e-05
run_12 | 3.0 | 27 | ss | 1.287e-02 | 1.037e-05
run_13 | 3.3 | 27 | ss | 1.388e-02 | 1.045e-05
run_14 | 3.6 | 27 | ss | 1.486e-02 | 1.054e-05
run_15 | 3.0 | 125 | ss | -1.610e-02 | 1.003e-05
run_16 | 3.3 | 125 | ss | -1.490e-02 | 1.010e-05
run_17 | 3.6 | 125 | ss | -1.371e-02 | 1.017e-05
run_18 | 3.0 | -40 | sf | -1.305e-02 | 1.029e-05
run_19 | 3.3 | -40 | sf | -1.220e-02 | 1.042e-05
run_20 | 3.6 | -40 | sf | -1.137e-02 | 1.055e-05
run_21 | 3.0 | 27 | sf | 1.374e-02 | 1.048e-05
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
