tatzelbrumm/gf180_cm_ip__single2diff2single/macros/ClassABBias/verification/cace/results/ClassABBiasBG/mm_params.csv

run | iterations | e_iout | Idd
run_0 | [1.000, 2.000, 3.000, …] | [2.498e-02, 2.081e-02, 4.817e-03, …] | [1.059e-05, 1.058e-05, 1.046e-05, …]
