tatzelbrumm/gf180_cm_ip__single2diff2single/macros/ClassABBias/verification/cace/results/ClassABBiasBG/off_params.csv

run | vdd | temp | corner_mos | Idd_off_end | iout_off
run_00 | 3.0 | -40 | typical | 1.762e-11 | 2.961e-12
run_01 | 3.6 | -40 | typical | 2.986e-11 | 7.482e-12
run_02 | 3.0 | 27 | typical | 9.351e-11 | 1.079e-11
run_03 | 3.6 | 27 | typical | 1.195e-10 | 1.556e-11
run_04 | 3.0 | 125 | typical | 1.512e-10 | 1.759e-11
run_05 | 3.6 | 125 | typical | 6.622e-11 | 2.114e-11
run_06 | 3.0 | -40 | ss | 1.672e-11 | 2.652e-12
run_07 | 3.6 | -40 | ss | 2.382e-11 | 4.788e-12
run_08 | 3.0 | 27 | ss | 9.239e-11 | 1.074e-11
run_09 | 3.6 | 27 | ss | 1.127e-10 | 1.268e-11
run_10 | 3.0 | 125 | ss | 2.222e-11 | 4.763e-12
run_11 | 3.6 | 125 | ss | 3.807e-11 | 1.071e-11
run_12 | 3.0 | -40 | ff | 9.081e-11 | 8.607e-12
run_13 | 3.6 | -40 | ff | 4.406e-11 | 1.373e-11
run_14 | 3.0 | 27 | ff | 1.079e-10 | 1.148e-11
run_15 | 3.6 | 27 | ff | 1.570e-10 | 2.298e-11
run_16 | 3.0 | 125 | ff | 1.898e-10 | 4.193e-11
run_17 | 3.6 | 125 | ff | 2.400e-10 | 6.483e-11
