tatzelbrumm/gf180_cm_ip__single2diff2single/macros/ClassABBias/verification/cace/results/ClassABBiasBG/tran_startup_params.csv

run | t_ramp | vdd | temp | corner_mos | t_startup | e_end
run_00 | 1e-6 | 3.0 | -40 | typical | 7.772e-07 | -1.307e-02
run_01 | 1e-3 | 3.0 | -40 | typical | -2.933e-04 | -1.307e-02
run_02 | 1e-6 | 3.6 | -40 | typical | 6.663e-07 | -1.136e-02
run_03 | 1e-3 | 3.6 | -40 | typical | -4.106e-04 | -1.136e-02
run_04 | 1e-6 | 3.0 | 27 | typical | 9.245e-07 | 1.373e-02
run_05 | 1e-3 | 3.0 | 27 | typical | -3.567e-04 | 1.373e-02
run_06 | 1e-6 | 3.6 | 27 | typical | 8.140e-07 | 1.573e-02
run_07 | 1e-3 | 3.6 | 27 | typical | -4.634e-04 | 1.573e-02
run_08 | 1e-6 | 3.0 | 125 | typical | 1.178e-06 | -1.504e-02
run_09 | 1e-3 | 3.0 | 125 | typical | -4.554e-04 | -1.504e-02
run_10 | 1e-6 | 3.6 | 125 | typical | 1.072e-06 | -1.261e-02
run_11 | 1e-3 | 3.6 | 125 | typical | -5.455e-04 | -1.261e-02
run_12 | 1e-6 | 3.0 | -40 | ss | 8.648e-07 | -1.378e-02
run_13 | 1e-3 | 3.0 | -40 | ss | -2.507e-04 | -1.378e-02
run_14 | 1e-6 | 3.6 | -40 | ss | 7.438e-07 | -1.208e-02
run_15 | 1e-3 | 3.6 | -40 | ss | -3.751e-04 | -1.208e-02
run_16 | 1e-6 | 3.0 | 27 | ss | 1.023e-06 | 1.287e-02
run_17 | 1e-3 | 3.0 | 27 | ss | -3.137e-04 | 1.287e-02
run_18 | 1e-6 | 3.6 | 27 | ss | 9.058e-07 | 1.486e-02
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
