tatzelbrumm/gf180_cm_ip__single2diff2single/macros/ClassABBias/verification/cace/results/ClassABBiasBG/e_iout_vs_corner_res.png

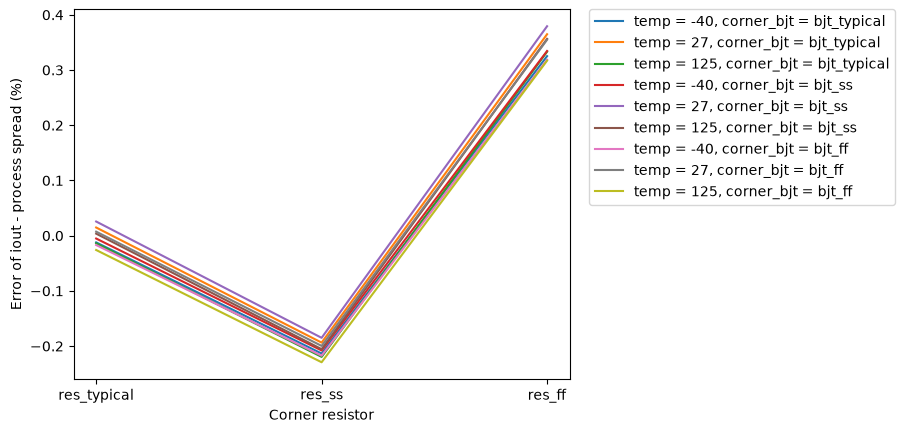
macros/ClassABBias/verification/cace/results/ClassABBiasBG/e_iout_vs_corner_res.png
