tatzelbrumm/gf180_cm_ip__single2diff2single/macros/ClassABBias/verification/cace/results/ClassABBiasIn/e_bp_vs_temp.png

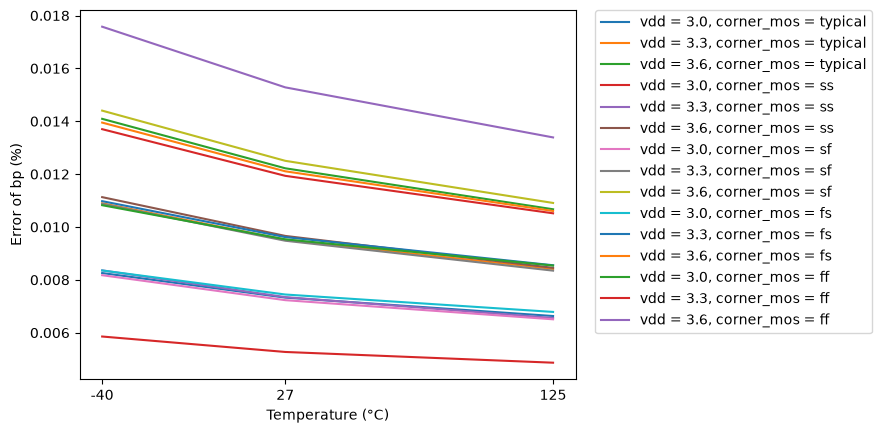
macros/ClassABBias/verification/cace/results/ClassABBiasIn/e_bp_vs_temp.png
