tatzelbrumm/gf180_cm_ip__single2diff2single/macros/ClassABBias/verification/cace/results/ClassABBiasOut/e_abp_vs_vdd.png

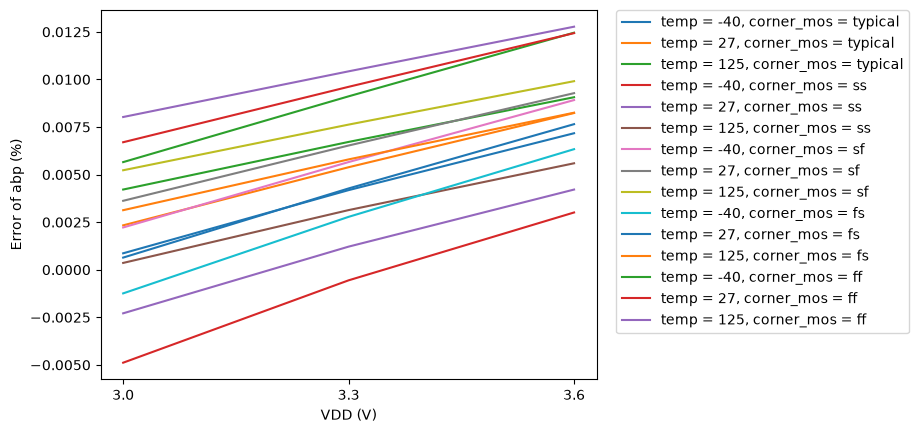
macros/ClassABBias/verification/cace/results/ClassABBiasOut/e_abp_vs_vdd.png
