tatzelbrumm/gf180_cm_ip__single2diff2single/macros/ClassABBias/verification/cace/results/ClassABBiasOut/e_bpc_vs_corner_mos.png

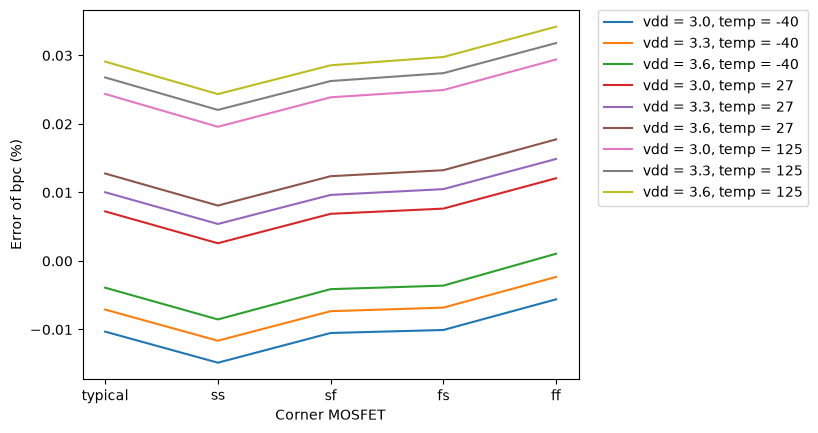
macros/ClassABBias/verification/cace/results/ClassABBiasOut/e_bpc_vs_corner_mos.png
