tatzelbrumm/gf180_cm_ip__single2diff2single/macros/ClassABDriver/verification/cace/results/ClassABDriverBiased/inl_vs_vdd.png

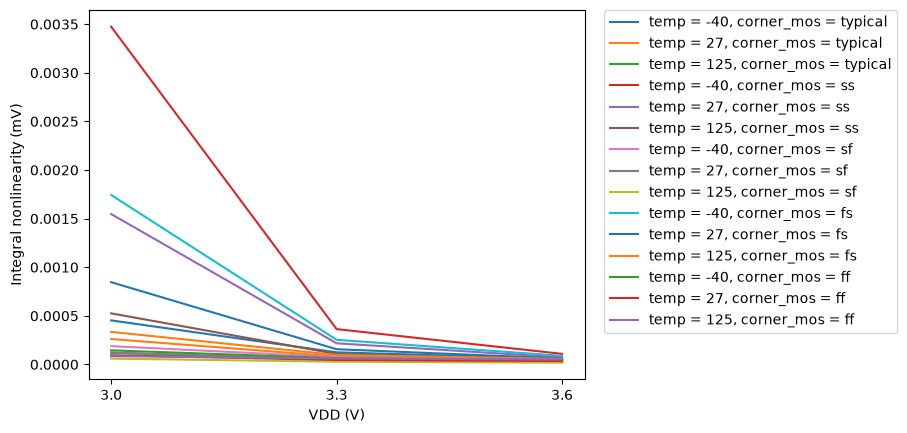
macros/ClassABDriver/verification/cace/results/ClassABDriverBiased/inl_vs_vdd.png
