tatzelbrumm/gf180_cm_ip__single2diff2single/macros/ClassABDriver/verification/cace/results/ClassABDriverBiased/pm_vs_temp.png

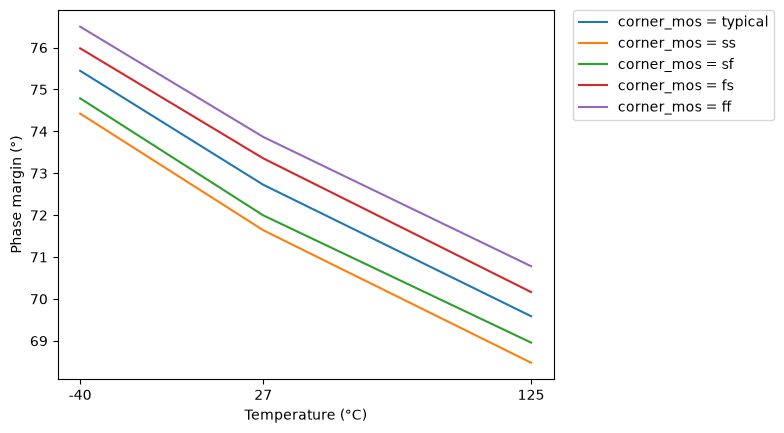
macros/ClassABDriver/verification/cace/results/ClassABDriverBiased/pm_vs_temp.png
