tatzelbrumm/gf180_cm_ip__single2diff2single/macros/ClassABDriver/verification/cace/results/ClassABDriverBiased/vos_vs_corner_mos.png

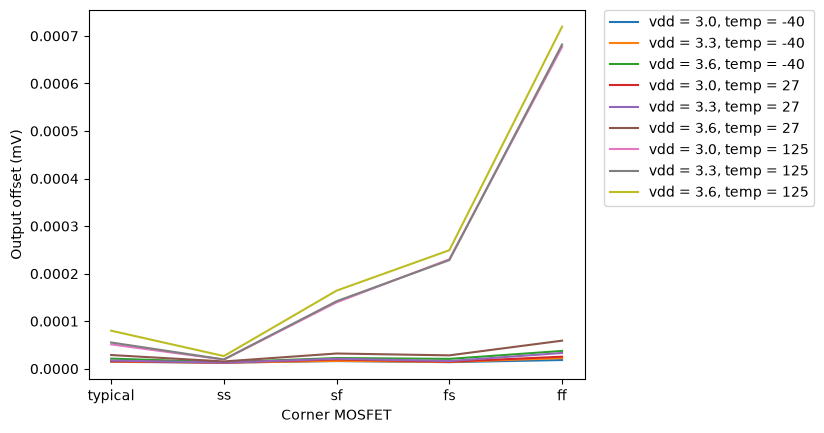
macros/ClassABDriver/verification/cace/results/ClassABDriverBiased/vos_vs_corner_mos.png
