tatzelbrumm/gf180_cm_ip__single2diff2single/macros/gf180mcu_IOPadDiff2Single/verification/cace/results/gf180mcu_IOPadDiff2Single/idd_off_vs_temp.png

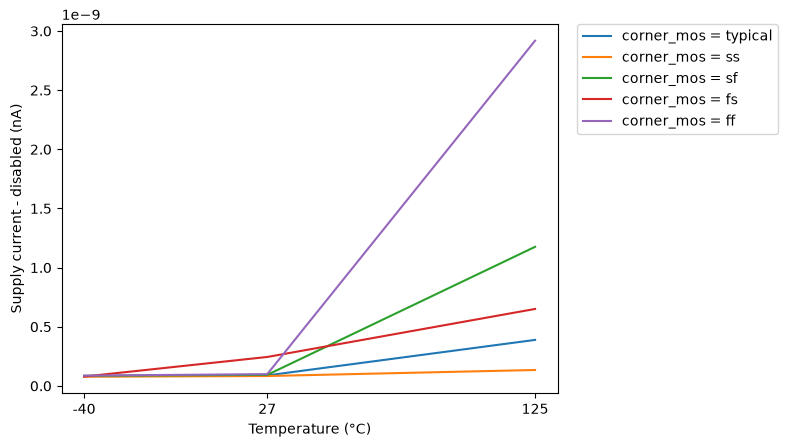
macros/gf180mcu_IOPadDiff2Single/verification/cace/results/gf180mcu_IOPadDiff2Single/idd_off_vs_temp.png
