tatzelbrumm/gf180_cm_ip__single2diff2single/macros/gf180mcu_IOPadSingle2Diff/verification/cace/results/gf180mcu_IOPadSingle2Diff/Iin_vs_vin.png

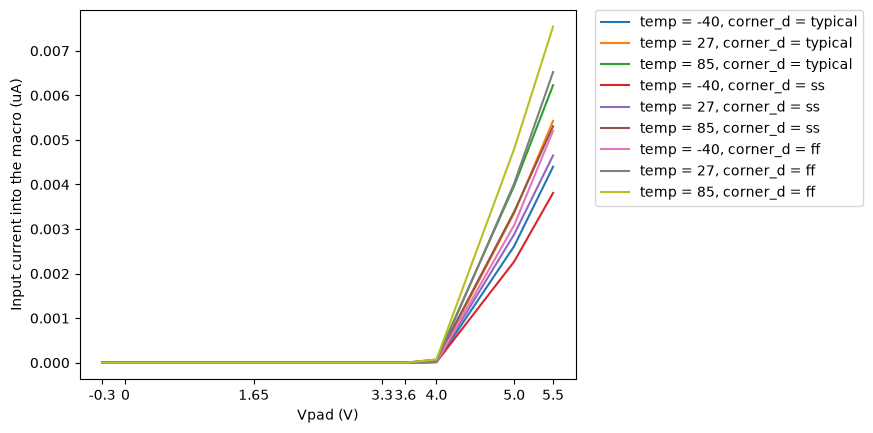
macros/gf180mcu_IOPadSingle2Diff/verification/cace/results/gf180mcu_IOPadSingle2Diff/Iin_vs_vin.png
