tatzelbrumm/gf180_cm_ip__single2diff2single/macros/OgueyAebischerBias/verification/cace/results/OgueyAebischerRef_03v3/Ibias_vs_vdd.png

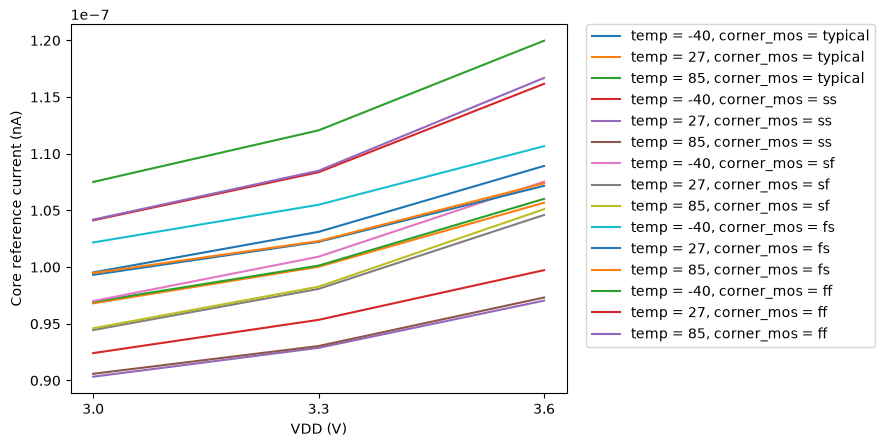
macros/OgueyAebischerBias/verification/cace/results/OgueyAebischerRef_03v3/Ibias_vs_vdd.png
