tatzelbrumm/gf180_cm_ip__single2diff2single/macros/OgueyAebischerBias/verification/cace/results/OgueyAebischerRef_06v0/t_startup_vs_corner_mos.png

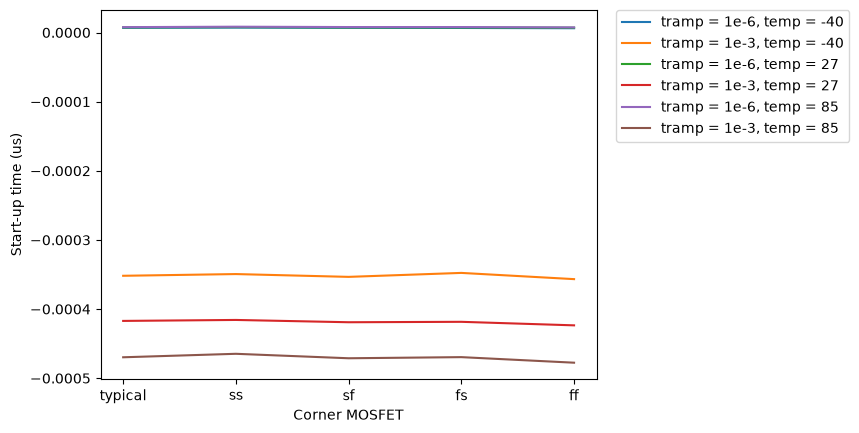
macros/OgueyAebischerBias/verification/cace/results/OgueyAebischerRef_06v0/t_startup_vs_corner_mos.png
