tatzelbrumm/gf180_cm_ip__single2diff2single/(commit log)

2026-10-06 Claude's purge of old sg13cmos5l stuff
    [counter_top_tb_tran.csv, counter_top_tb_tran.sch, inverter.sch, inverter_tb_ac.csv, inverter_tb_ac.sch, inverter_tb_ac_ol.csv, inverter_tb_ac_ol.sch, inverter_tb_dc_vout.csv]
2026-10-07 Transfer to gf180 from sg13cmos5L by Claude Opus
    [OgueyAebischerBias_03v3.sch, OgueyAebischerBias_06v0.sch, OgueyAebischerRef_03v3.sch, OgueyAebischerRef_03v3_tb_ac_psrr.sch, OgueyAebischerRef_03v3_tb_dc.sch, OgueyAebischerRef_03v3_tb_dc_mm.sch, OgueyAebischerRef_03v3_tb_noise.sch, OgueyAebischerRef_03v3_tb_tran.sch]
2026-10-07 macros/OgueyAebischerBias/schematic/xschem/*.sch testbenches/xschem/*.sch : minor cosmetic changes to schematics, testbenches ran successfully
    [OgueyAebischerBias_03v3.sch, OgueyAebischerBias_06v0.sch, OgueyAebischerRef_03v3.sch, OgueyAebischerRef_03v3_tb_tran.sch, OgueyAebischerRef_06v0.sch, OgueyAebischerRef_06v0_tb_tran.sch, ToBiasStartup_03v3.sch, ToBiasStartup_06v0.sch]
2026-10-07 macros/OgueyAebischerBias/verification/cace/templates/OgueyAebischerRef_*_tb_*.sch : moved text in CACE template schematics for legibility, functionally unmodified
    [OgueyAebischerRef_03v3_tb_tran.sch, OgueyAebischerRef_03v3_tb_tran_disable.sch, OgueyAebischerRef_06v0_tb_dc_mm.sch, OgueyAebischerRef_06v0_tb_noise.sch, OgueyAebischerRef_06v0_tb_tran.sch]
2026-10-08 Claude Opus build of macro structure for pads, based on IHP sg13cmos5l version
    [BiasRefEnable.sch, ClassABBiasIdeal.sch, ClassABBiasIn.sch, ClassABBiasIn_tb_dc.sch, ClassABBiasIn_tb_line.sch, ClassABBiasOut.sch, ClassABBiasOut_tb_dc.sch, ClassABBiasOut_tb_line.sch]
2026-10-08 macros/ClassABDriver/schematic/xschem macros/PadEnable/schematic/xschem : schematics hand edited
    [BiasRefEnable.sch, ClassABDriver.sch, ClassABUnitR.sch, DriverEnable.sch, EnableInv.sch, InputEnable.sch]
2026-10-08 Redesign of Class AB bandgap reference by Claude Fable
    [ClassABBiasBG.sch, ClassABBiasBGTree.sch, ClassABBiasBGTree_tb_dc.sch, ClassABBiasBG_tb_dc.sch, ClassABBiasBG_tb_line.sch, ClassABBiasBG_tb_off.sch, ClassABBiasBG_tb_startup.sch, ClassABBiasBGdn.sch]
2026-10-09 macros/ClassABBias/schematic/xschem/ClassABBias*.sch macros/PadEnable/schematic/xschem/RefCoreEnable.sch : hand edited schematics for better human readability and as examples to Claude's xschem-analo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
    [ClassABBiasBG.sch, ClassABBiasBGTree.sch, ClassABBiasBGdn.sch, ClassABBiasIdeal.sch, RefCoreEnable.sch]
2026-10-09 macros/ClassABBias : update Claude's scripts in response to hand edited schematics
2026-10-09 macros/PadEnable/schematic/xschem/TGate.sch .sym auto generated by Claude Opus. Schematic needs editing.
2026-10-10 macros/PadEnable/schematic/xschem/TGate.sch .sym, creation script, and test bench by Claude Opus
